joshsanz/POV_Display/(commit log)

2014-02-20 Added LED matrix driver
2014-02-22 Added hearts arrays
    display does not currently light up
2014-02-22 Added bars to sides
    g1 and g2 were flipped
    [rgbLED.ino]
2014-02-22 Fixed sensitivity for photoresistor
    The heart changes size!
    [rgbLED.ino]
2014-02-26 add materials to readme
2014-02-26 added assembly pictures, updated readme
2014-02-26 fixed merge errors in arduino code
    not sure why merge was so screwy
    [rgbLED.ino]
